LujainAlawneh/micromouse-robot/proposal/README.md

 # Project Management

We used Trello to organize the Micromouse project, divide tasks between team members,
track progress, and manage the different stages of development.

The board includes tasks related to hardware, software, CAD design, testing,
integration, and final project preparation.

[Open Trello Board](https://trello.com/b/rr6KHJKg/micromouse-robot-design-project)
