LujainAlawneh/micromouse-robot/proposal/Presentation.pdf

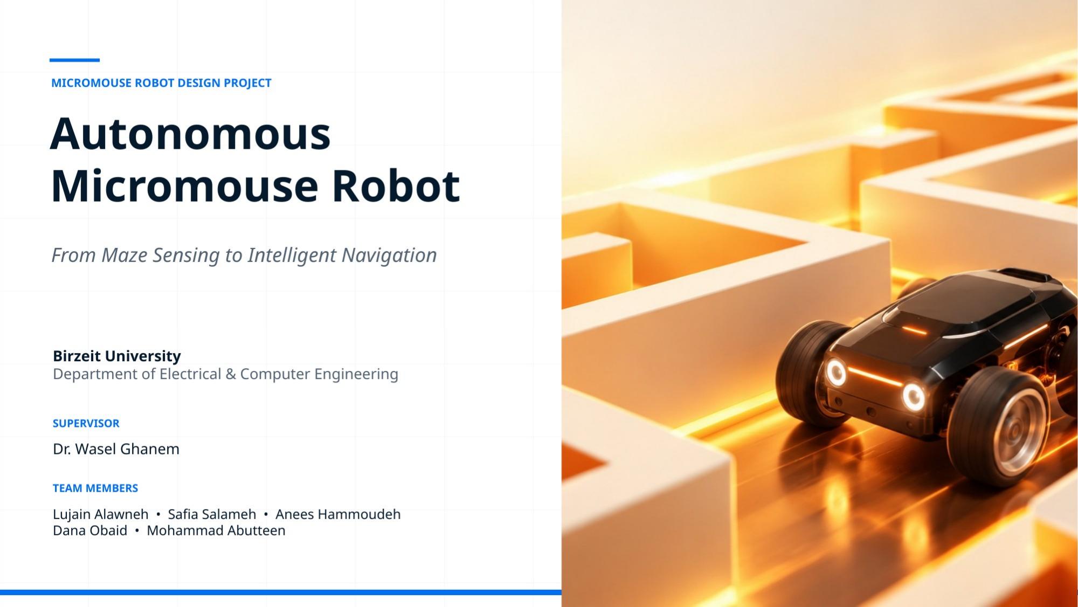
[picture p1: page 1]
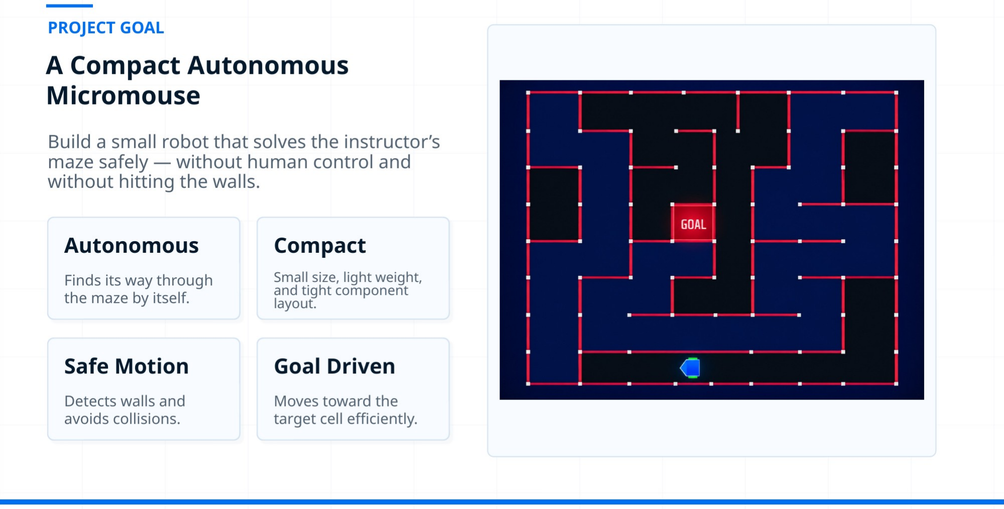
[picture p2: page 2]
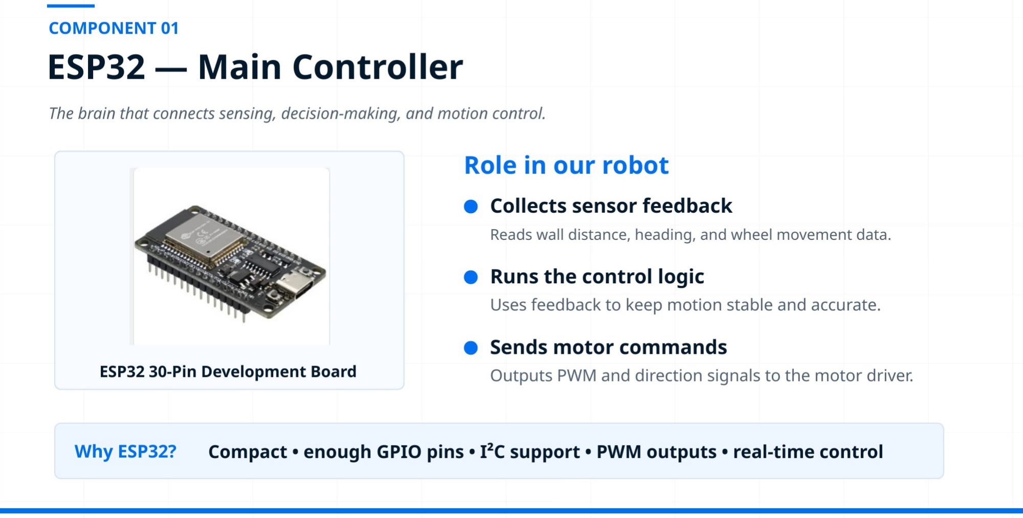
[picture p3: page 3]
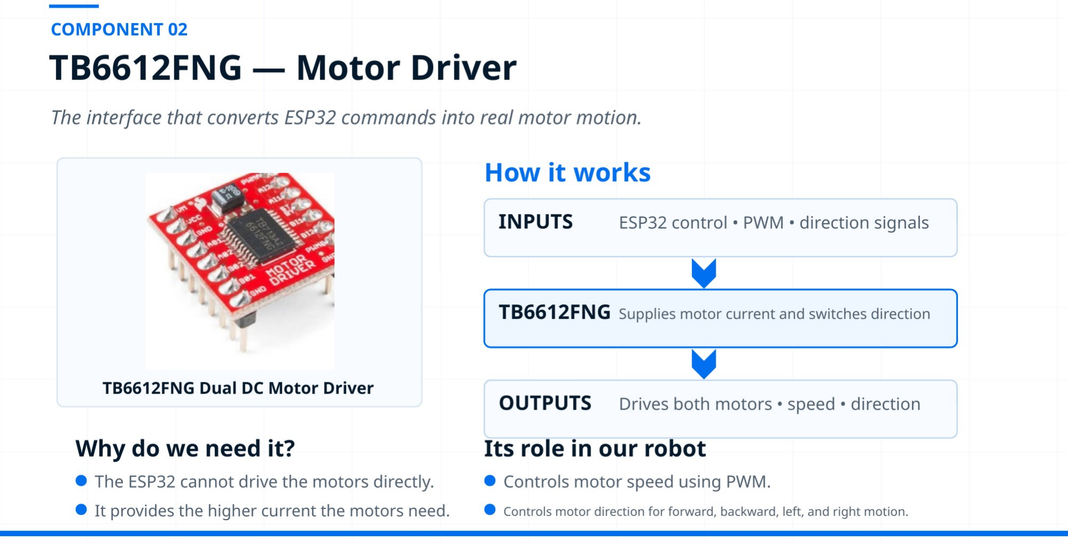
[picture p4: page 4]

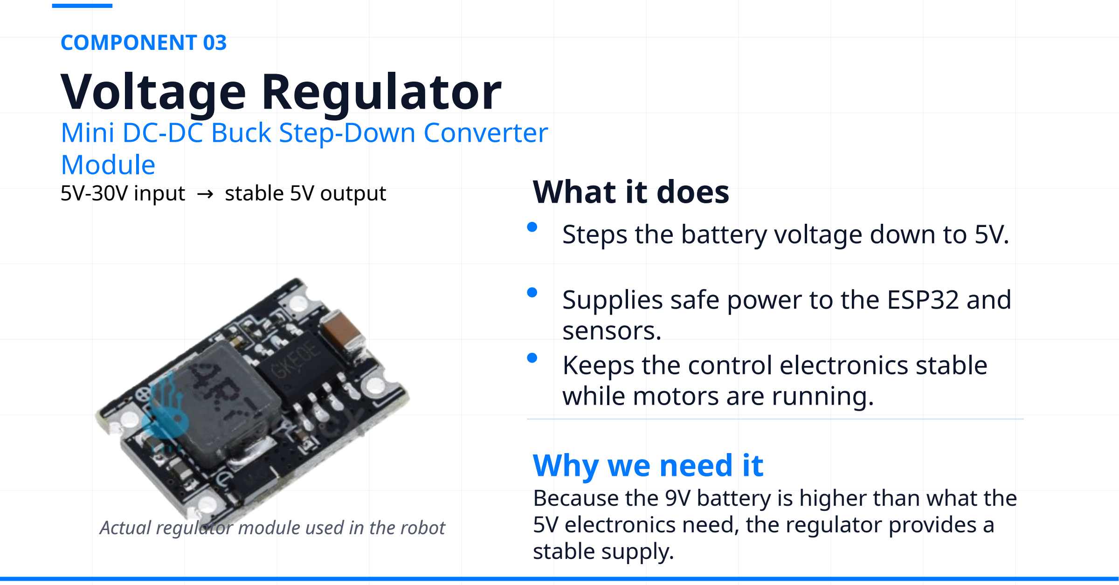
[picture p5: figure]
COMPONENT 03 Voltage Regulator; Mini DC-DC Buck Step-Down Converter Module; 5V-30V input; stable 5V output →; What it does Steps the battery voltage down to 5V.; Supplies safe power to the ESP32 and sensors. Keeps the control electronics stable while motors are running.; Why we need it; stable supply.

### Actual regulator module used in the robot

## Because the 9V battery is higher than what the 5V electronics need, the regulator provides a

## COMPONENT 04

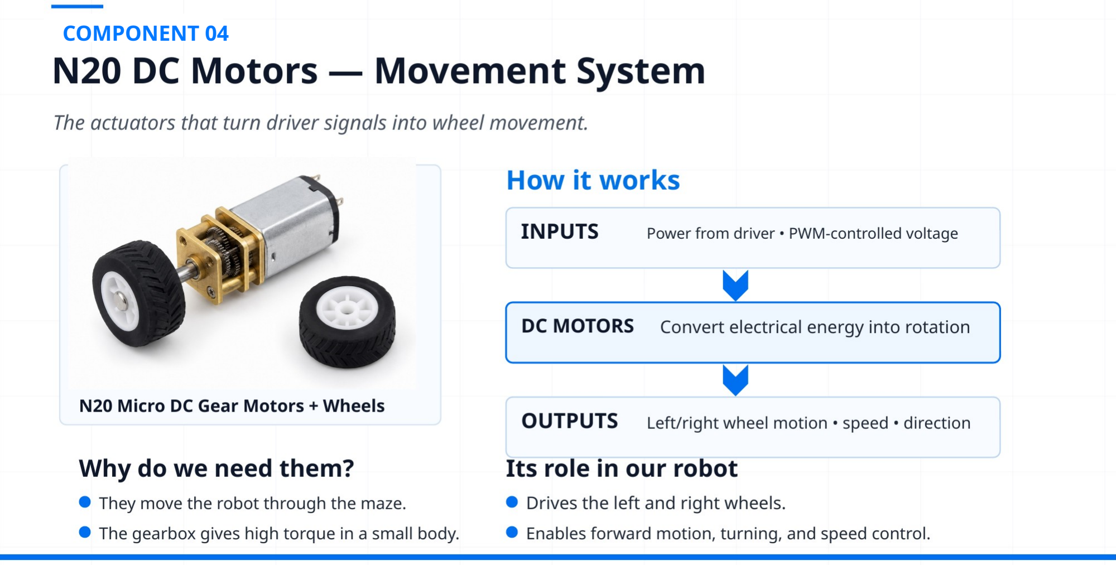
[picture p6: page 6]

## COMPONENT 05

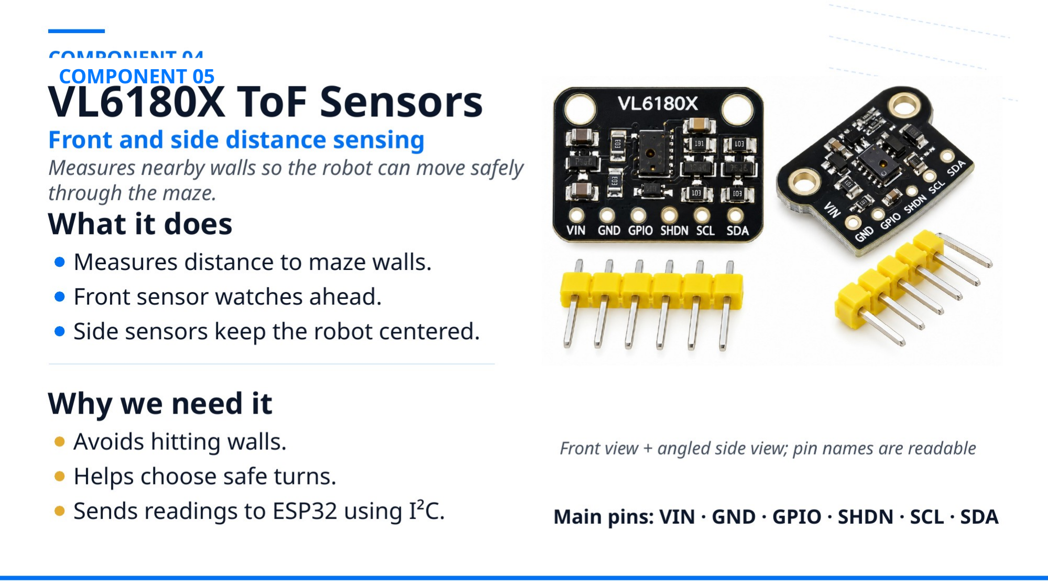
[picture p7: page 7]

## COMPONENT 06

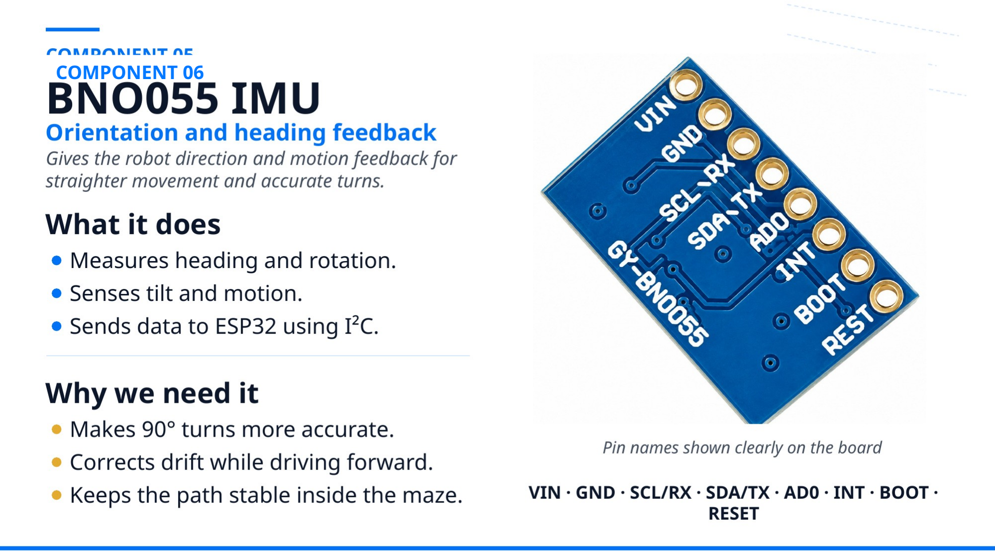
[picture p8: page 8]

## COMPONENT 07

# Wheel Encoders

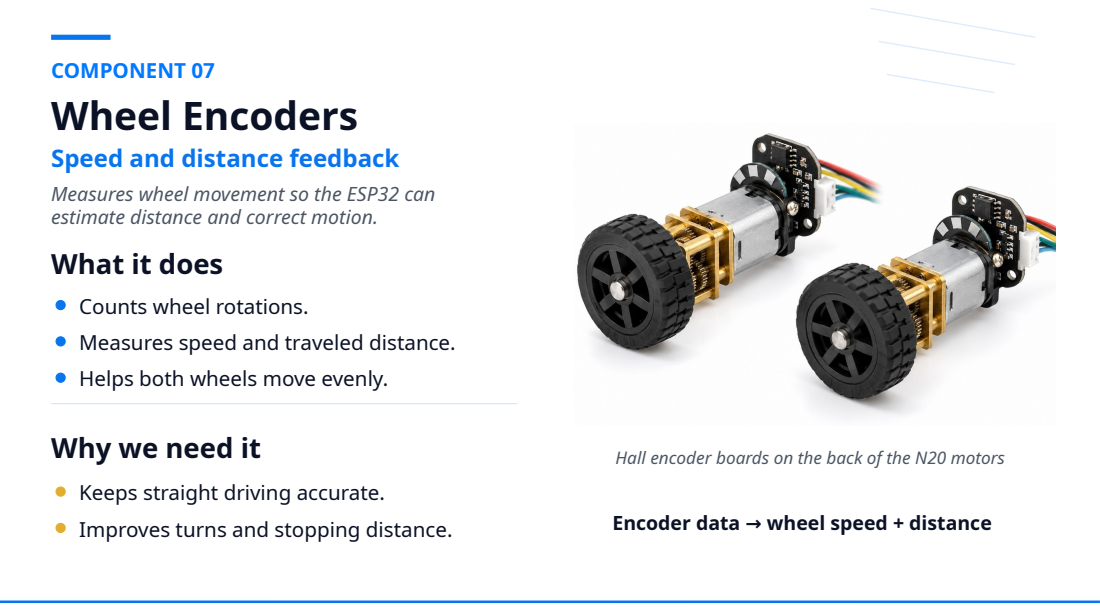
[picture p9: page 9]

Speed and distance feedback
Measures wheel movement so the ESP32 can
estimate distance and correct motion.
What it does
Counts wheel rotations.
Measures speed and traveled distance.
Helps both wheels move evenly.
Why we need it
Keeps straight driving accurate.
Improves turns and stopping distance.

Hall encoder boards on the back of the N20 motors

Encoder data wheel speed + distance →

## COMPONENT 08 9V Rechargeable Li-ion Battery

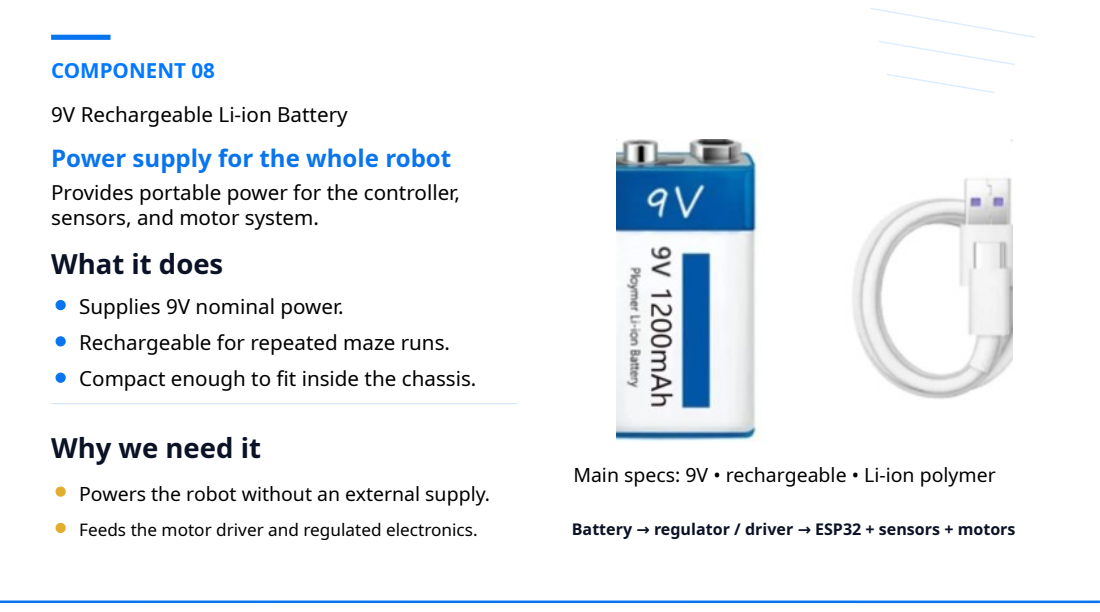
[picture p10: page 10]
Battery regulator / driver ESP32 + sensors + motors →

Power supply for the whole robot
Provides portable power for the controller,
sensors, and motor system.
What it does
Supplies 9V nominal power.
Rechargeable for repeated maze runs.
Compact enough to fit inside the chassis.
Why we need it

Main specs: 9V • rechargeable • Li-ion polymer

Powers the robot without an external supply.
Feeds the motor driver and regulated electronics.

## COMPONENT 09

# Chassis

### Mechanical structure and component mounting

## Custom 3D-printed base and top cover hold the

robot parts in place.

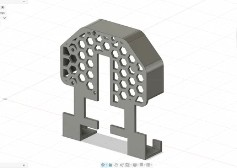
[picture p11: figure]
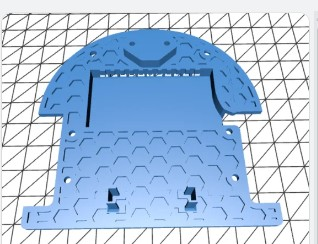
[picture p12: figure]

Chassis base | Final top case
Holds motors, PCB, sensors, and battery. Keeps it compact and mechanically stable. | Provides mounting points and protects internal components. Custom design fits our Micromouse layout.

# Robot Wiring Diagram — Adopted Connection Layout

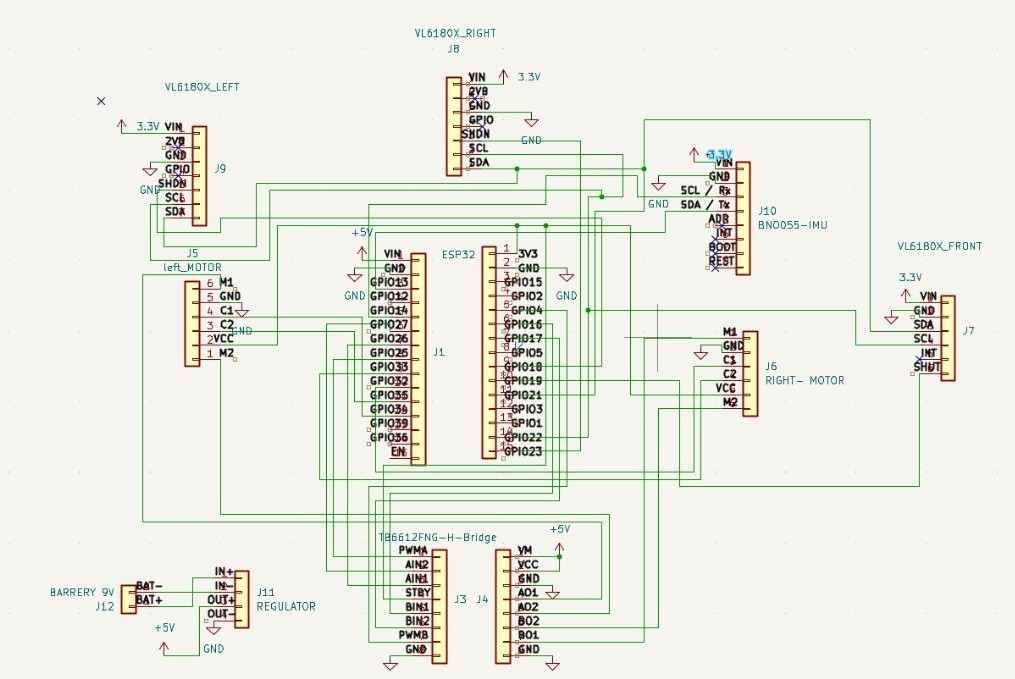
[picture p13: figure]
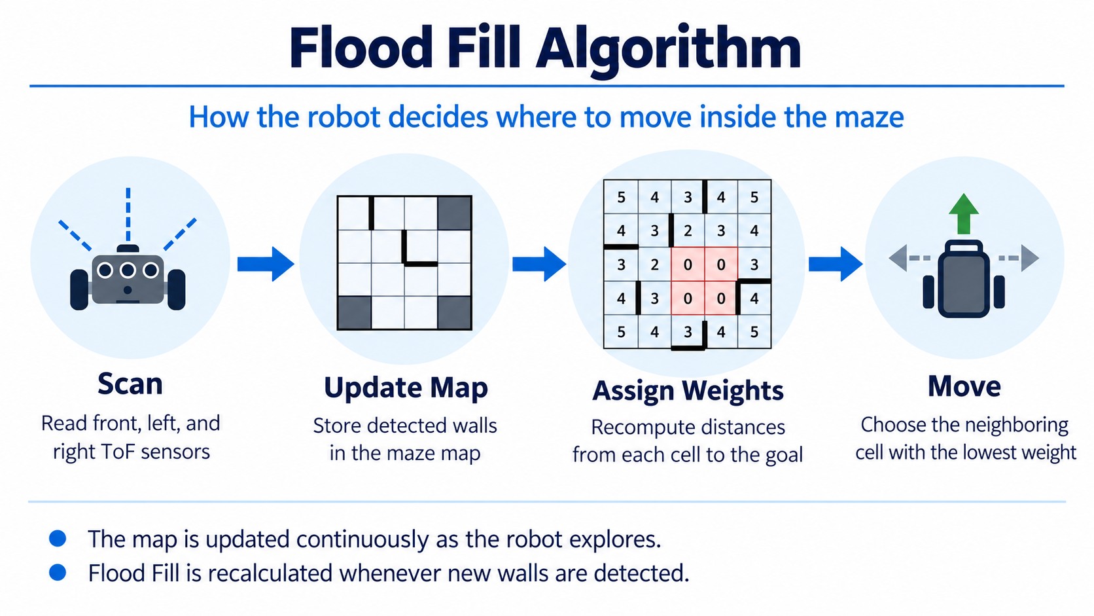
[picture p14: page 13]

# Flood Fill Integration in Our Robot

## How sensing, mapping, planning, and motion control worked together

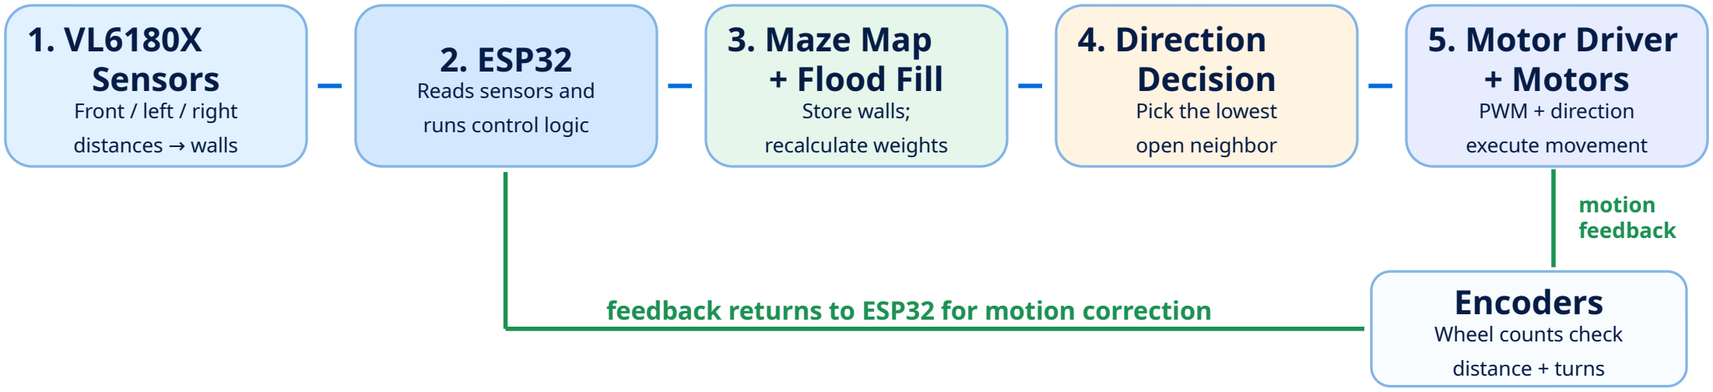
[picture p15: figure]
1. VL6180X Sensors Front / left / right distances walls →; 2. ESP32 Reads sensors and runs control logic; 3. Maze Map + Flood Fill Store walls; recalculate weights; 4. Direction Decision Pick the lowest open neighbor; 5. Motor Driver + Motors PWM + direction execute movement; Encoders Wheel counts check distance + turns; motion feedback

feedback returns to ESP32 for motion correction

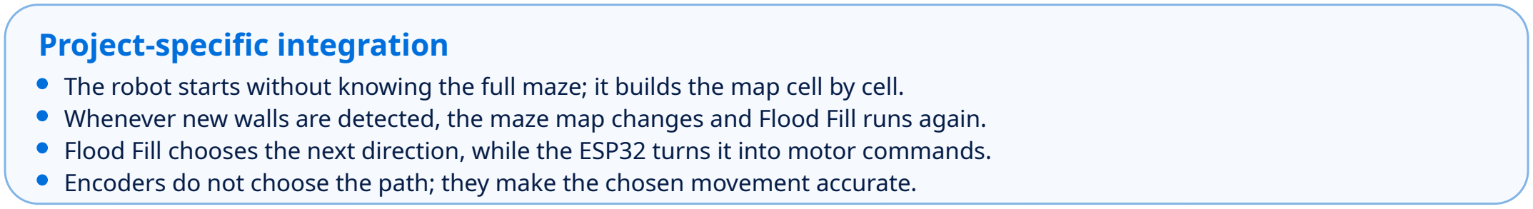
[picture p16: figure]
Project-specific integration

The robot starts without knowing the full maze; it builds the map cell by cell. Whenever new walls are detected, the maze map changes and Flood Fill runs again. Flood Fill chooses the next direction, while the ESP32 turns it into motor commands.
Encoders do not choose the path; they make the chosen movement accurate.
Takeaway: sensors discover walls ESP32 updates the map Flood Fill plans motors move encoders verify. → | → | → | →

# How Flood Fill Worked in Our Project

## Project-specific navigation cycle, not just the general algorithm

Sensing + Mapping | Planning + Motion

## 1 Read distances

Front, left, and right VL6180X sensors measure wall distance in the current cell.

## 2 Detect walls

The ESP32 converts distance readings into wall / no-wall information.

## 3 Update maze map

Newly detected walls are stored in the robot’s internal maze representation.

## 4 Recalculate Flood Fill

If the map changes, cell values are recomputed using the known walls.

5

## Choose direction

Select the accessible neighboring cell with the lowest Flood Fill value.

## 6 Move accurately

Motors execute the move; encoders help verify one-cell motion and 90° turns.
updated map

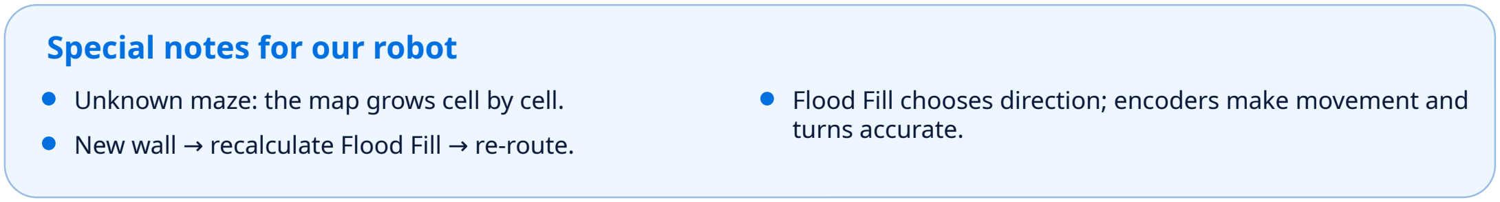
[picture p17: figure]
Special notes for our robot; turns accurate.

Unknown maze: the map grows cell by cell.
New wall recalculate Flood Fill re-route. → | →

Flood Fill chooses direction; encoders make movement and

# Power Budget — Battery Requirement

Component | Qty | Operating Voltage | Worst-case Current | Total Worst-case Power
ESP32 30-pin | 1 | 5 V | 500 mA | 2.50 W
N20 530 RPM Motors | 2 | 5 V | 200 mA each | 2.00 W
VL6180X ToF Sensors | 3 | 5 V | 40 mA each | 0.60 W
BMI160 IMU | 1 | 3.3 V | 0.99 mA | 0.003 W ≈
TB6612FNG Motor Driver | 1 | 5 V (logic) | 2.2 mA | 0.011 W ≈
MP1584EN Regulator | 1 | 9 V 5 V → | — | Assume 90% efficiency ≈
9V Battery (Source) | 1 | 9 V | Must supply 570–630 mA ≈ | —
TOTAL LOAD | | | | ≈ 5.11 W

We calculated the power requirements of the main Micromouse components to estimate the total system load and determine the battery requirements.
The estimated total load was approximately 5.11 W, with the 9V battery required to supply around 570–630 mA.
This calculation helped us select a suitable power source with an appropriate safety margin.

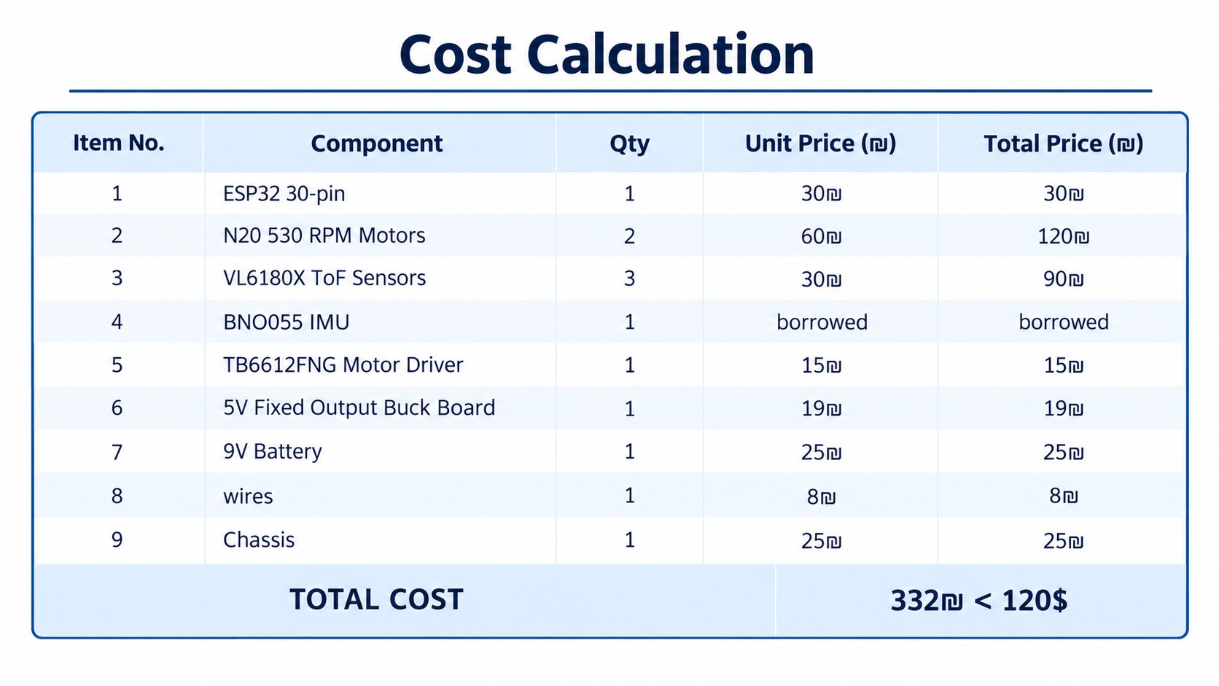
[picture p18: page 17]

# Challenges & Solutions

## What we fixed during mechanical assembly, wiring, motor testing, and motion tuning

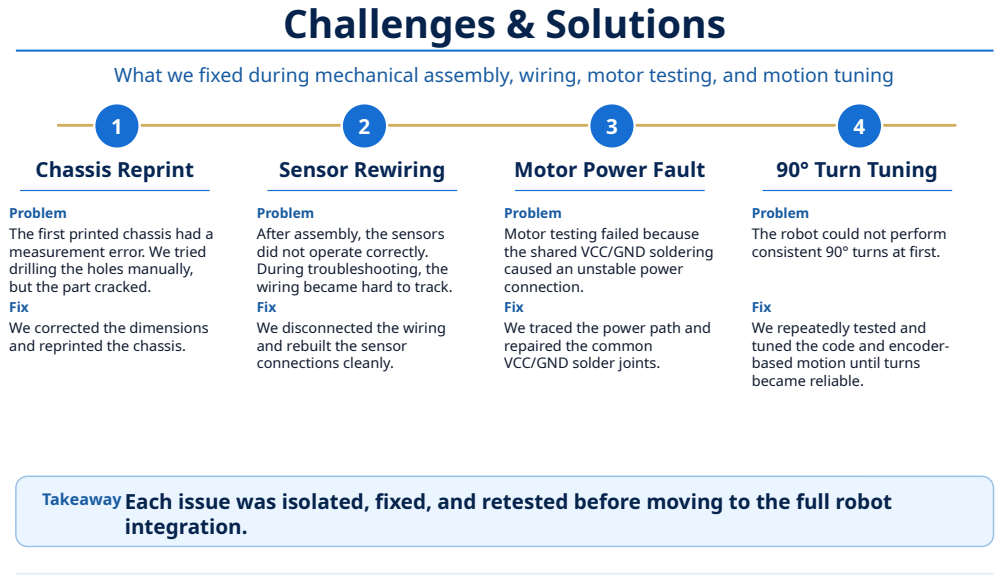
[picture p19: page 18]
Chassis Reprint; Sensor Rewiring; 90° Turn Tuning

Motor Power Fault

Problem
The first printed chassis had a
measurement error. We tried
drilling the holes manually,
but the part cracked.
Fix
We corrected the dimensions
and reprinted the chassis.

After assembly, the sensors
did not operate correctly.
During troubleshooting, the
wiring became hard to track.
We disconnected the wiring
and rebuilt the sensor
connections cleanly.

Motor testing failed because
the shared VCC/GND soldering
caused an unstable power
connection.
We traced the power path and
repaired the common
VCC/GND solder joints.

The robot could not perform
consistent 90° turns at first.

We repeatedly tested and
tuned the code and encoder-
based motion until turns
became reliable.

Takeaway Each issue was isolated, fixed, and retested before moving to the full robot
integration.

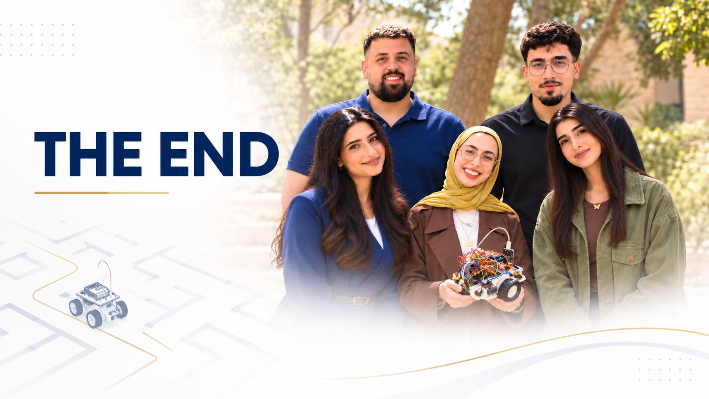
[picture p20: page 19]
