LujainAlawneh/micromouse-robot/(commit log)

2026-10-03 Insert circuit schematic image in README
    Added an image of the circuit schematic to the README.
2026-10-03 Create CAD
2026-10-03 Add initial README.md for CAD project
